amrithHN/stm32f4xx_minimal_dev/README.md

# Stm32f407 based board with barometer sensor
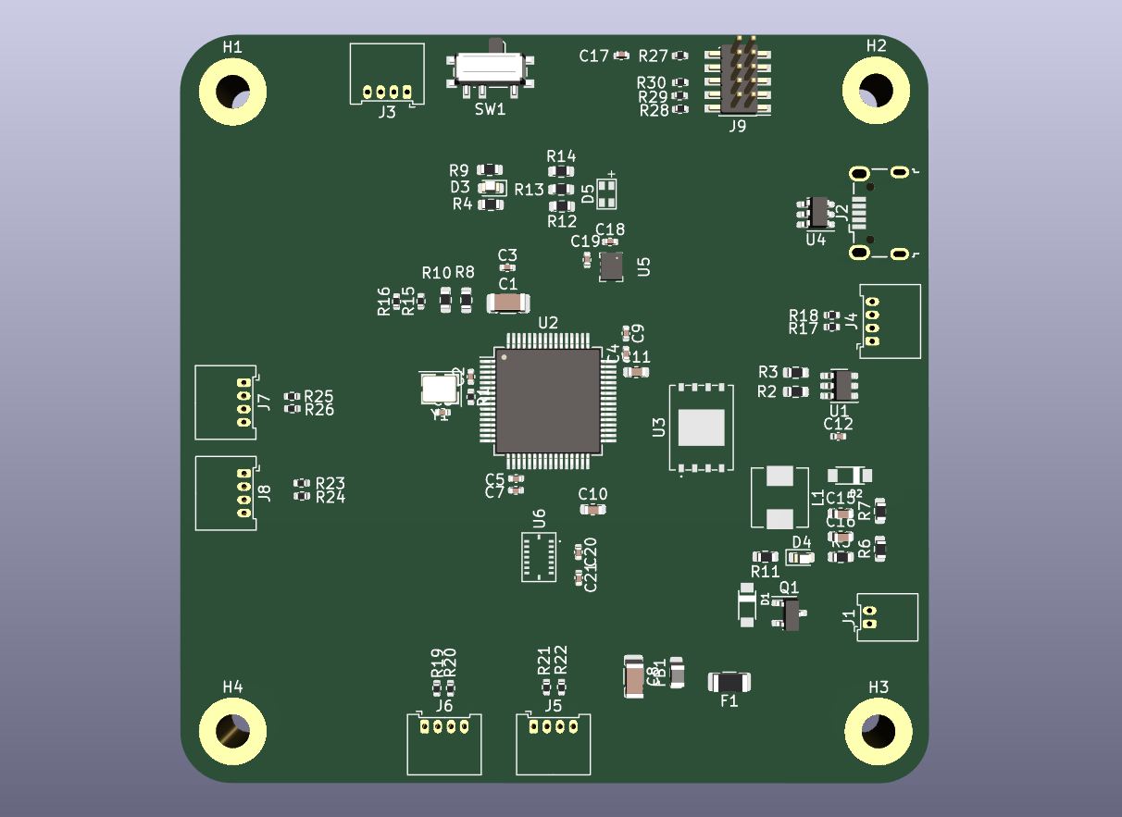
[picture p1: Screenshot 2022-11-29 144700.png]


GPL license
