amrithHN/stm32f4xx_minimal_dev/Documentation/wp5687319.webp

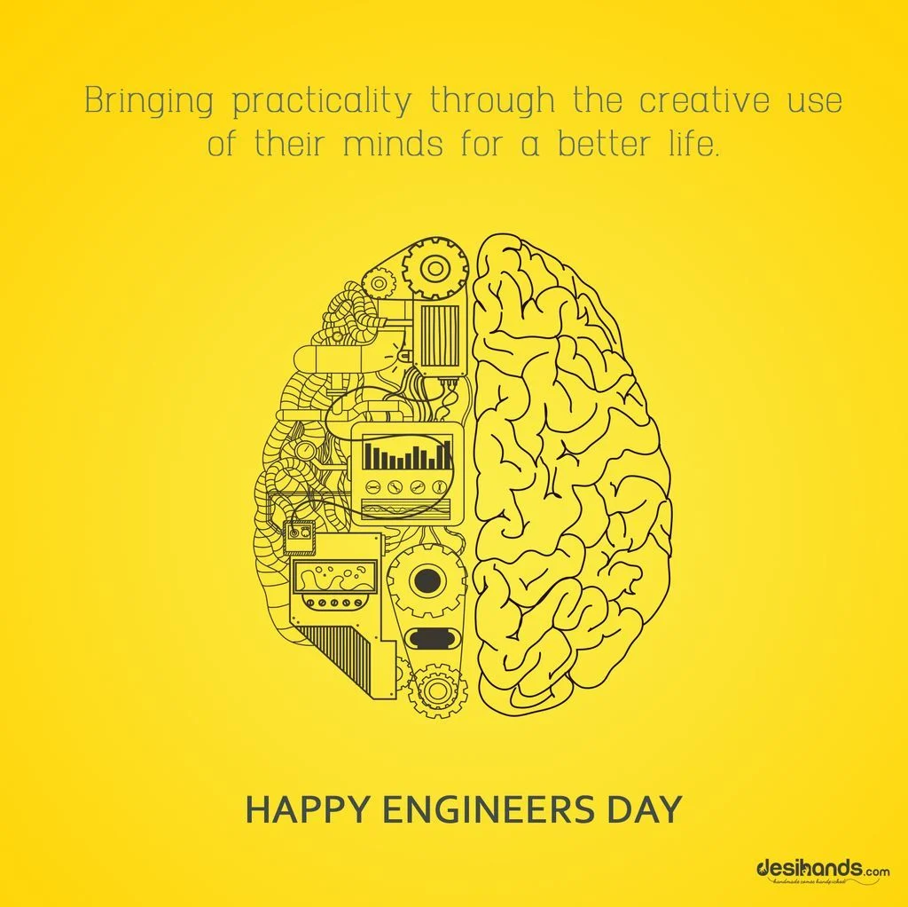
Documentation/wp5687319.webp
