amrithHN/stm32f4xx_minimal_dev/3DModels/STM32F405RGT6.STEP

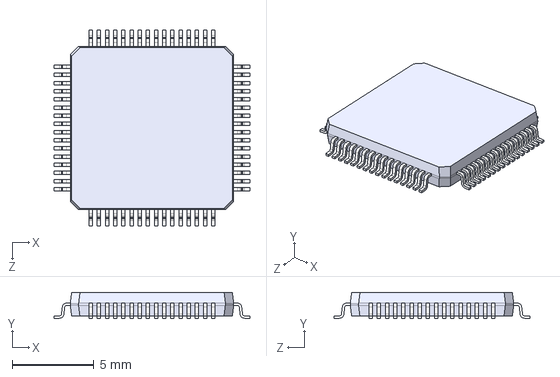
[picture p3: CAD file, 2022-11-20]
3DModels/STM32F405RGT6.STEP
12.0 x 1.60 x 12.0 mm
