amrithHN/stm32f4xx_minimal_dev/B5819W-TP/B5819W-TP.step

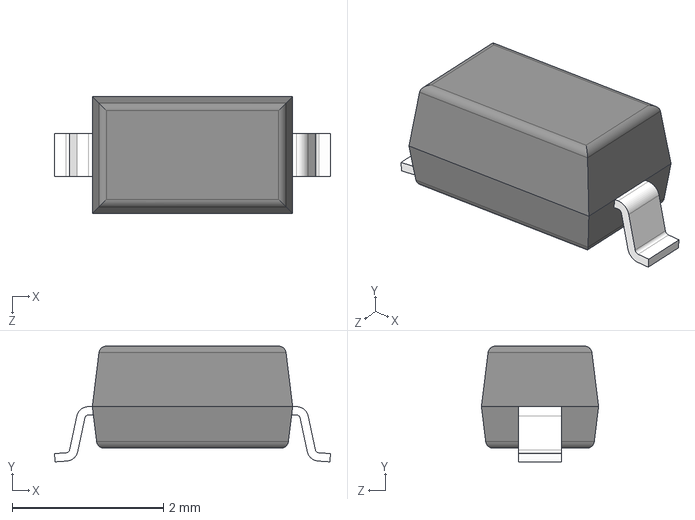
[picture p4: CAD file, 2022-11-29]
B5819W-TP/B5819W-TP.step
3.65 x 1.53 x 1.55 mm
