amrithHN/stm32f4xx_minimal_dev/BMI088/BMI088.step

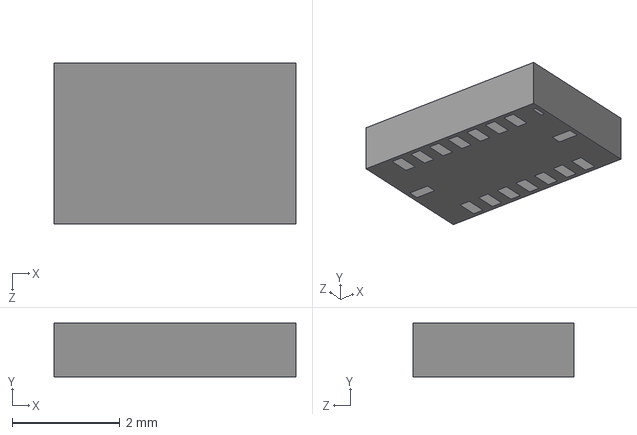
[picture p5: CAD file, 2022-11-20]
BMI088/BMI088.step
4.50 x 1.00 x 3.00 mm
