amrithHN/stm32f4xx_minimal_dev/BMP280/BMP280.step

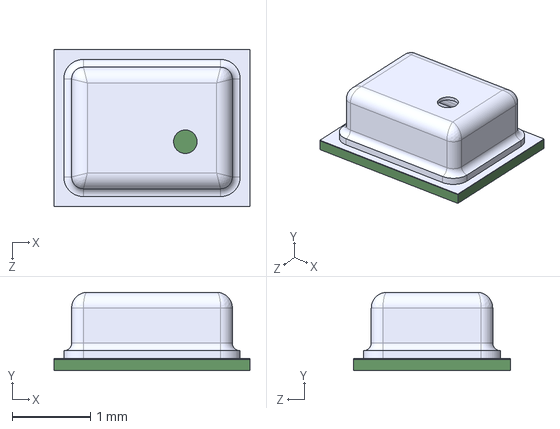
[picture p6: CAD file, 2022-11-20]
BMP280/BMP280.step
2.50 x 1.00 x 2.00 mm
