amrithHN/stm32f4xx_minimal_dev/W25N01GVZEIG_TR/W25N01GVZEIG_TR.step

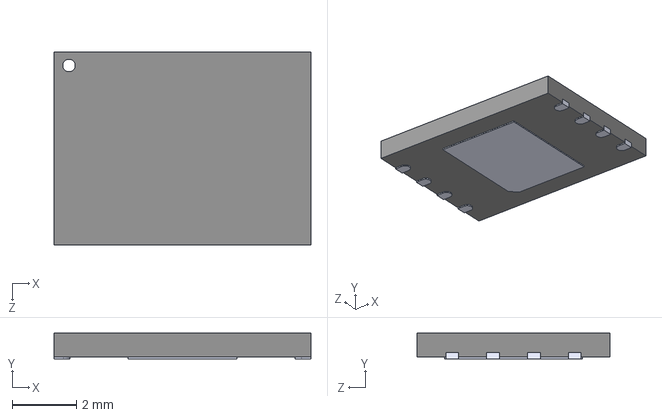
[picture p7: CAD file, 2022-11-20]
W25N01GVZEIG_TR/W25N01GVZEIG_TR.step
8.00 x 0.8 x 6.00 mm
