amrithHN/stm32f4xx_minimal_dev/stm32_f4xx_minimal.kicad_pcb

## KiCad design stm32_f4xx_minimal.kicad_pcb (2022-11-29)

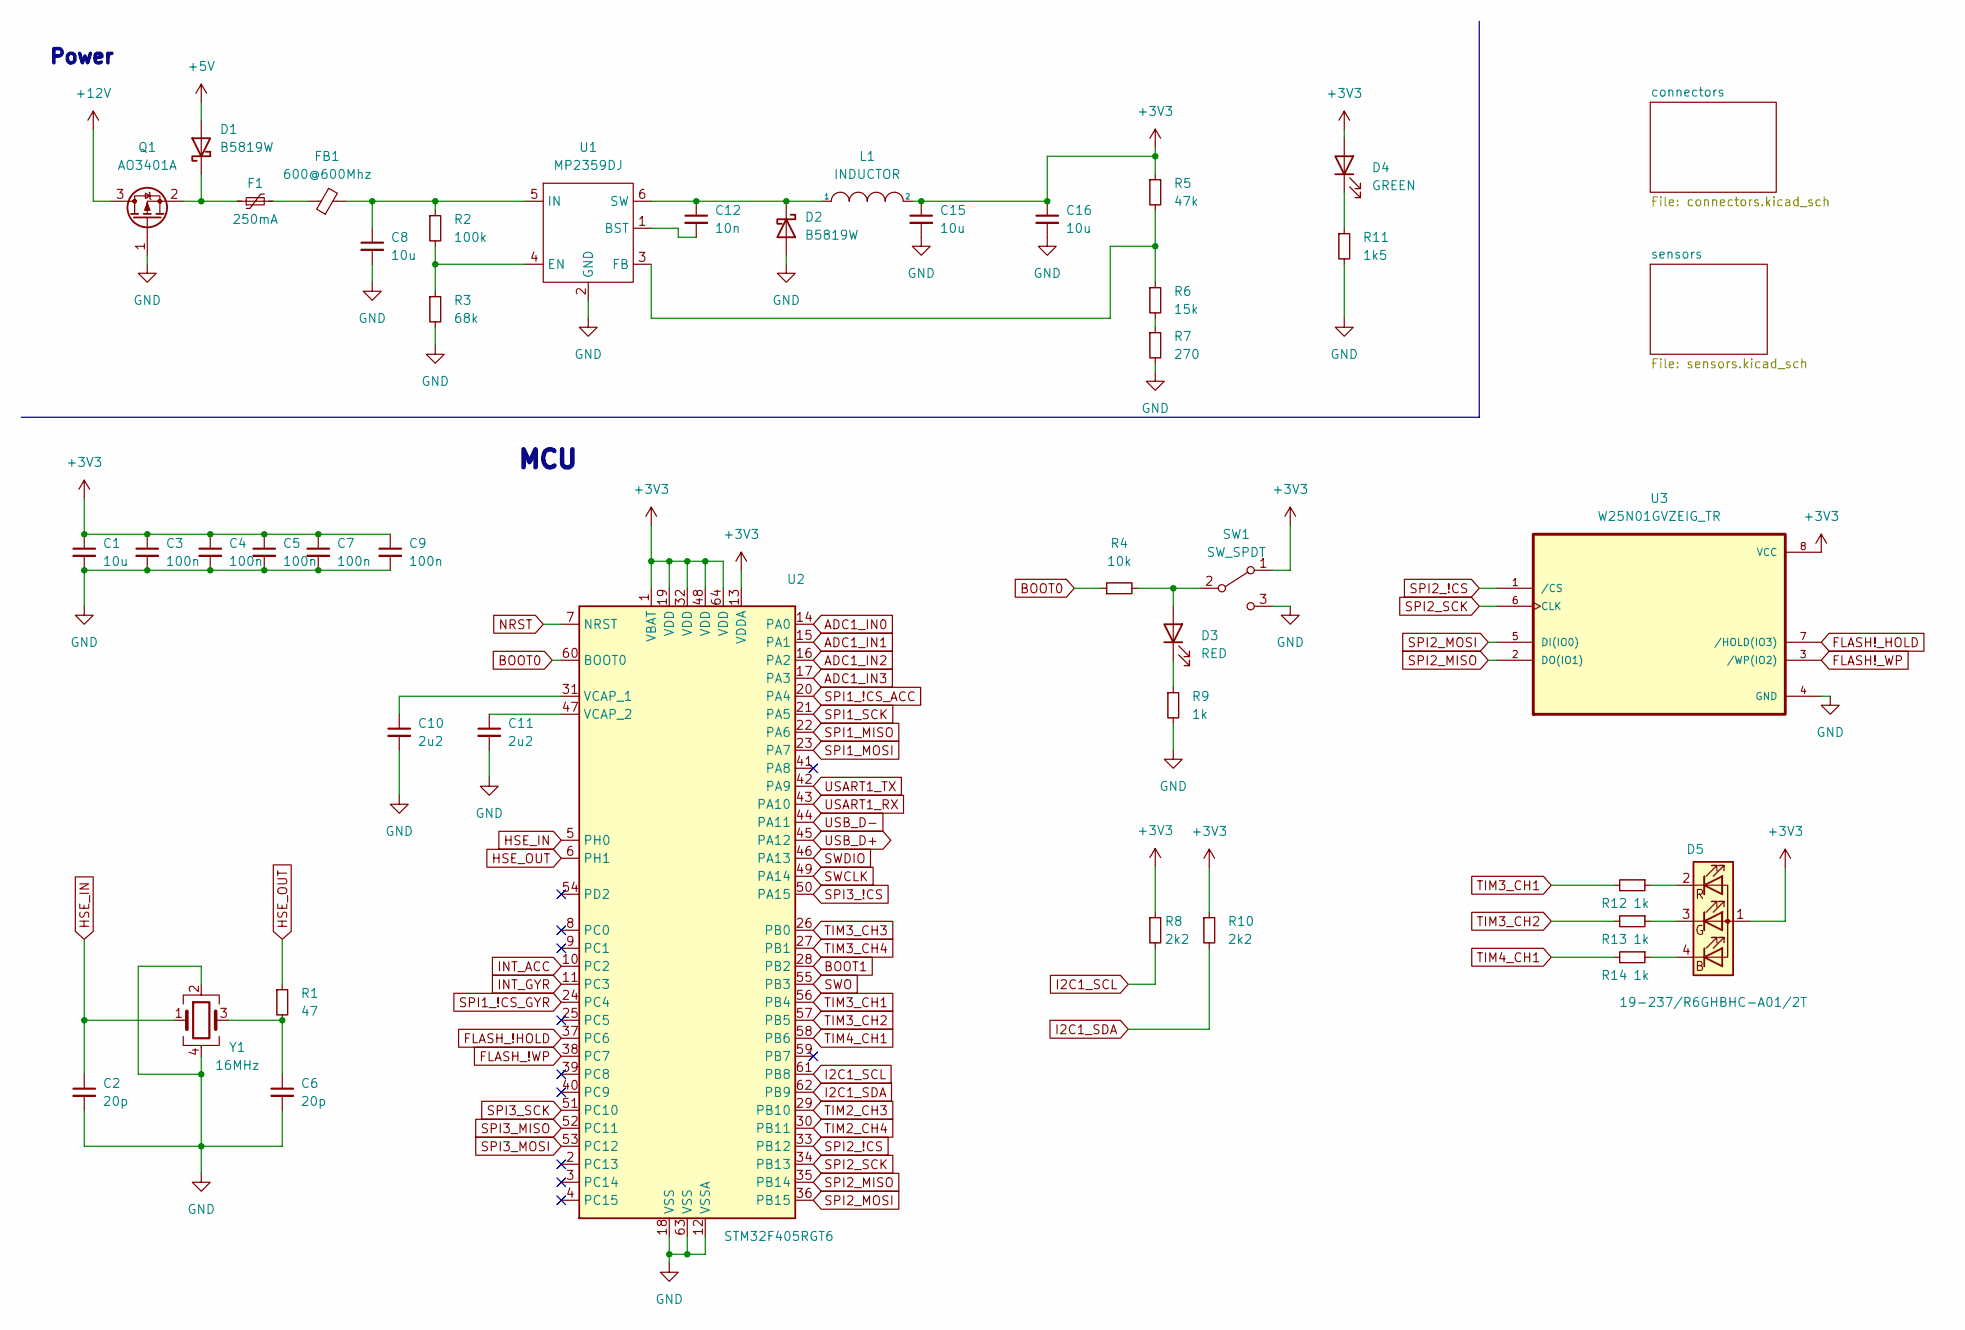
[picture p8: schematic stm32_f4xx_minimal.kicad_sch, Stm32f405RGT6]

Parts:
C1, C8: 10u; C_1206_3216Metric
C2, C6: 20p; C_0402_1005Metric
C3, C4, C5, C7, C9: 100n; C_0402_1005Metric
C10, C11: 2u2; C_0603_1608Metric
C12: 10n; C_0402_1005Metric
C15, C16: 10u; C_0603_1608Metric
D1, D2: B5819W; SOD3716X135N
D3: RED; LED_0603_1608Metric
D4: GREEN; LED_0603_1608Metric
D5: 19-237/R6GHBHC-A01/2T; 19-237-R6GHBHC-A01-2T
F1: 250mA; Fuse_1206_3216Metric
FB1: 600@600Mhz; L_0805_2012Metric
L1: INDUCTOR; L_Sunlord_MWSA0518_5.4x5.2mm
Q1: AO3401A; SOT-23
R1: 47; R_0402_1005Metric
R2: 100k; R_0603_1608Metric
R3: 68k; R_0603_1608Metric
R4: 10k; R_0603_1608Metric
R5: 47k; R_0603_1608Metric
R6: 15k; R_0603_1608Metric
R7: 270; R_0603_1608Metric
R8, R10: 2k2; R_0603_1608Metric
R9, R12, R13, R14: 1k; R_0603_1608Metric
R11: 1k5; R_0603_1608Metric
SW1: SW_SPDT; SW_SPDT_PCM12
U1: MP2359DJ; SOT-23-6
U2: STM32F405RGT6; LQFP-64_10x10mm_P0.5mm
U3: W25N01GVZEIG_TR; W25N01GVZEIG
Y1: 16MHz; Crystal_SMD_3225-4Pin_3.2x2.5mm

Connections:
+3V3: C1.1, C3.1, C4.1, C5.1, C7.1, C9.1, C15.1, C16.1, D4.2 (A), D5.1 (A), L1.2, R5.1, R8.1, R10.1, SW1.1 (A), U2.1 (VBAT), U2.13 (VDDA), U2.19 (VDD), U2.32 (VDD), U2.48 (VDD), U2.64 (VDD), U3.8 (VCC); also elsewhere on the board
+5V: D1.2 (A); also elsewhere on the board
+12V: Q1.3 (D); also elsewhere on the board
ADC1_IN0: U2.14 (PA0); also elsewhere on the board
ADC1_IN1: U2.15 (PA1); also elsewhere on the board
ADC1_IN2: U2.16 (PA2); also elsewhere on the board
ADC1_IN3: U2.17 (PA3); also elsewhere on the board
BOOT0: R4.1, U2.60 (BOOT0)
BOOT1: U2.28 (PB2)
FLASH!_HOLD: U3.7 (/HOLD(IO3))
FLASH!_WP: U3.3 (/WP(IO2))
FLASH_!HOLD: U2.37 (PC6)
FLASH_!WP: U2.38 (PC7)
GND: C1.2, C2.2, C3.2, C4.2, C5.2, C6.2, C7.2, C8.2, C9.2, C10.2, C11.2, C15.2, C16.2, D2.2 (A), Q1.1 (G), R3.2, R7.2, R9.2, R11.2, SW1.3 (C), U1.2 (GND), U2.12 (VSSA), U2.18 (VSS), U2.63 (VSS), U3.4 (GND), Y1.2, Y1.4; also elsewhere on the board
HSE_IN: C2.1, U2.5 (PH0), Y1.1
HSE_OUT: R1.1, U2.6 (PH1)
I2C1_SCL: R8.2, U2.61 (PB8); also elsewhere on the board
I2C1_SDA: R10.2, U2.62 (PB9); also elsewhere on the board
INT_ACC: U2.10 (PC2); also elsewhere on the board
INT_GYR: U2.11 (PC3); also elsewhere on the board
NRST: U2.7 (NRST); also elsewhere on the board
unnamed: C6.1, R1.2, Y1.3
unnamed: C8.1, FB1.2, R2.1, U1.5 (IN)
unnamed: C10.1, U2.31 (VCAP_1)
unnamed: C11.1, U2.47 (VCAP_2)
unnamed: C12.1, D2.1 (K), L1.1, U1.6 (SW)
unnamed: C12.2, U1.1 (BST)
unnamed: D1.1 (K), F1.1, Q1.2 (S)
unnamed: D3.1 (K), R9.1
unnamed: D3.2 (A), R4.2, SW1.2 (B)
unnamed: D4.1 (K), R11.1
unnamed: D5.2 (RK), R12.1
unnamed: D5.3 (GK), R13.1
unnamed: D5.4 (BK), R14.1
unnamed: F1.2, FB1.1
unnamed: R2.2, R3.1, U1.4 (EN)
unnamed: R5.2, R6.1, U1.3 (FB)
unnamed: R6.2, R7.1
SPI1_!CS_ACC: U2.20 (PA4); also elsewhere on the board
SPI1_!CS_GYR: U2.24 (PC4); also elsewhere on the board
SPI1_MISO: U2.22 (PA6); also elsewhere on the board
SPI1_MOSI: U2.23 (PA7); also elsewhere on the board
SPI1_SCK: U2.21 (PA5); also elsewhere on the board
SPI2_!CS: U2.33 (PB12), U3.1 (/CS)
SPI2_MISO: U2.35 (PB14), U3.2 (DO(IO1))
SPI2_MOSI: U2.36 (PB15), U3.5 (DI(IO0))
SPI2_SCK: U2.34 (PB13), U3.6 (CLK)
SPI3_!CS: U2.50 (PA15); also elsewhere on the board
SPI3_MISO: U2.52 (PC11); also elsewhere on the board
SPI3_MOSI: U2.53 (PC12); also elsewhere on the board
SPI3_SCK: U2.51 (PC10); also elsewhere on the board
SWCLK: U2.49 (PA14); also elsewhere on the board
SWDIO: U2.46 (PA13); also elsewhere on the board
SWO: U2.55 (PB3); also elsewhere on the board
TIM2_CH3: U2.29 (PB10); also elsewhere on the board
TIM2_CH4: U2.30 (PB11); also elsewhere on the board
TIM3_CH1: R12.2, U2.56 (PB4)
TIM3_CH2: R13.2, U2.57 (PB5)
TIM3_CH3: U2.26 (PB0); also elsewhere on the board
TIM3_CH4: U2.27 (PB1); also elsewhere on the board
TIM4_CH1: R14.2, U2.58 (PB6)
USART1_RX: U2.43 (PA10); also elsewhere on the board
USART1_TX: U2.42 (PA9); also elsewhere on the board
USB_D+: U2.45 (PA12); also elsewhere on the board
USB_D-: U2.44 (PA11); also elsewhere on the board

Notes on the sheet:
MCU
Power

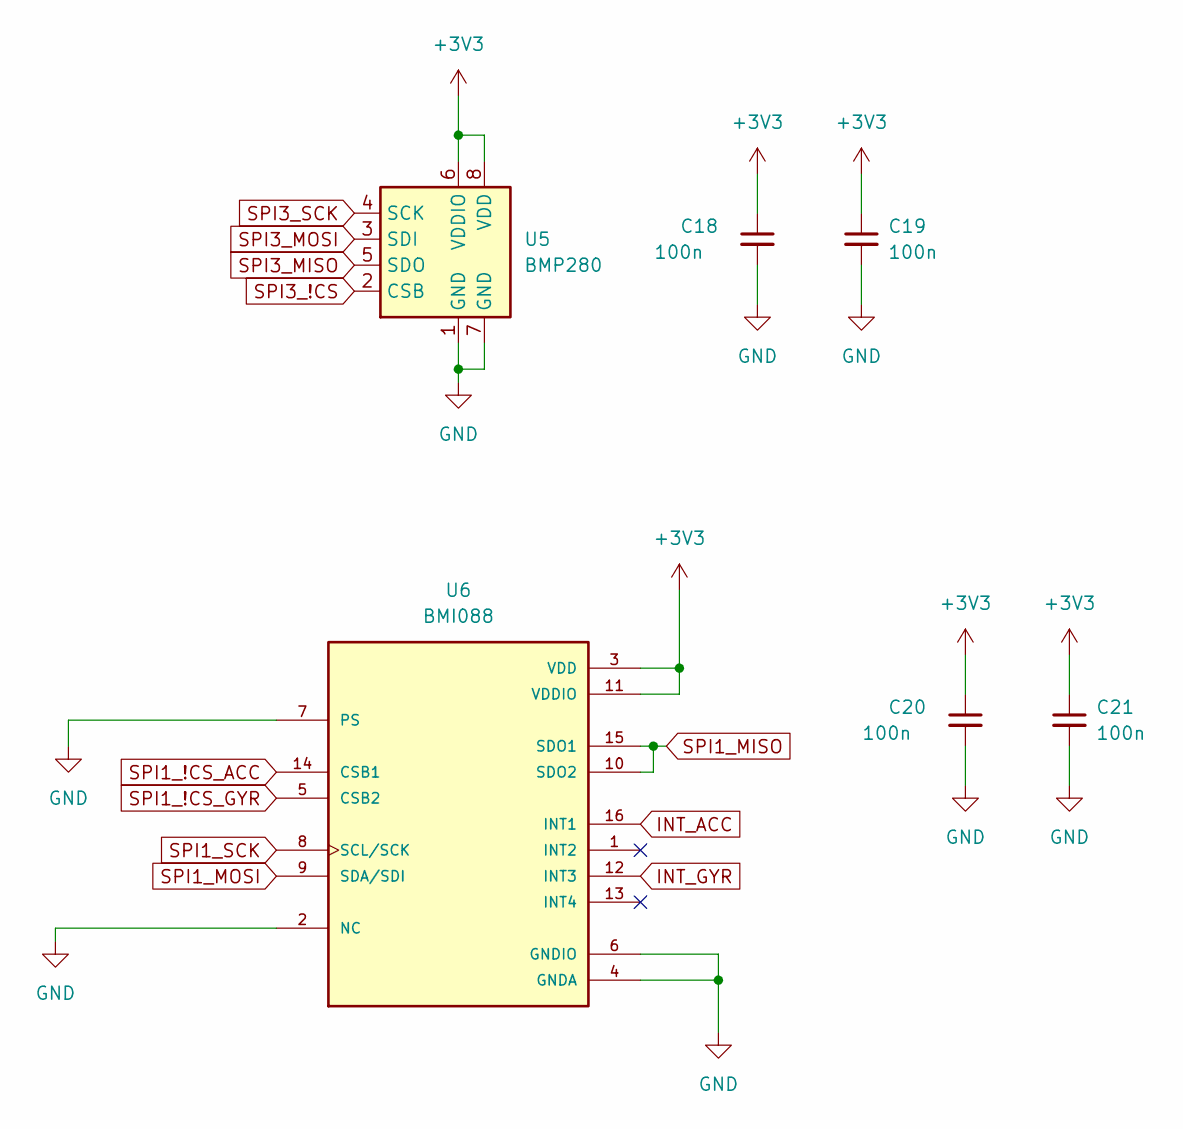
[picture p9: schematic sensors.kicad_sch]

Parts:
C18, C19, C20, C21: 100n; C_0402_1005Metric
U5: BMP280; Bosch_LGA-8_2x2.5mm_P0.65mm_ClockwisePinNumbering
U6: BMI088

Connections:
+3V3: C18.1, C19.1, C20.1, C21.1, U5.6 (VDDIO), U5.8 (VDD), U6.3 (VDD), U6.11 (VDDIO); also elsewhere on the board
GND: C18.2, C19.2, C20.2, C21.2, U5.1 (GND), U5.7 (GND), U6.2 (NC), U6.4 (GNDA), U6.6 (GNDIO), U6.7 (PS); also elsewhere on the board
INT_ACC: U6.16 (INT1); also elsewhere on the board
INT_GYR: U6.12 (INT3); also elsewhere on the board
SPI1_!CS_ACC: U6.14 (CSB1); also elsewhere on the board
SPI1_!CS_GYR: U6.5 (CSB2); also elsewhere on the board
SPI1_MISO: U6.10 (SDO2), U6.15 (SDO1); also elsewhere on the board
SPI1_MOSI: U6.9 (SDA/SDI); also elsewhere on the board
SPI1_SCK: U6.8 (SCL/SCK); also elsewhere on the board
SPI3_!CS: U5.2 (CSB); also elsewhere on the board
SPI3_MISO: U5.5 (SDO); also elsewhere on the board
SPI3_MOSI: U5.3 (SDI); also elsewhere on the board
SPI3_SCK: U5.4 (SCK); also elsewhere on the board

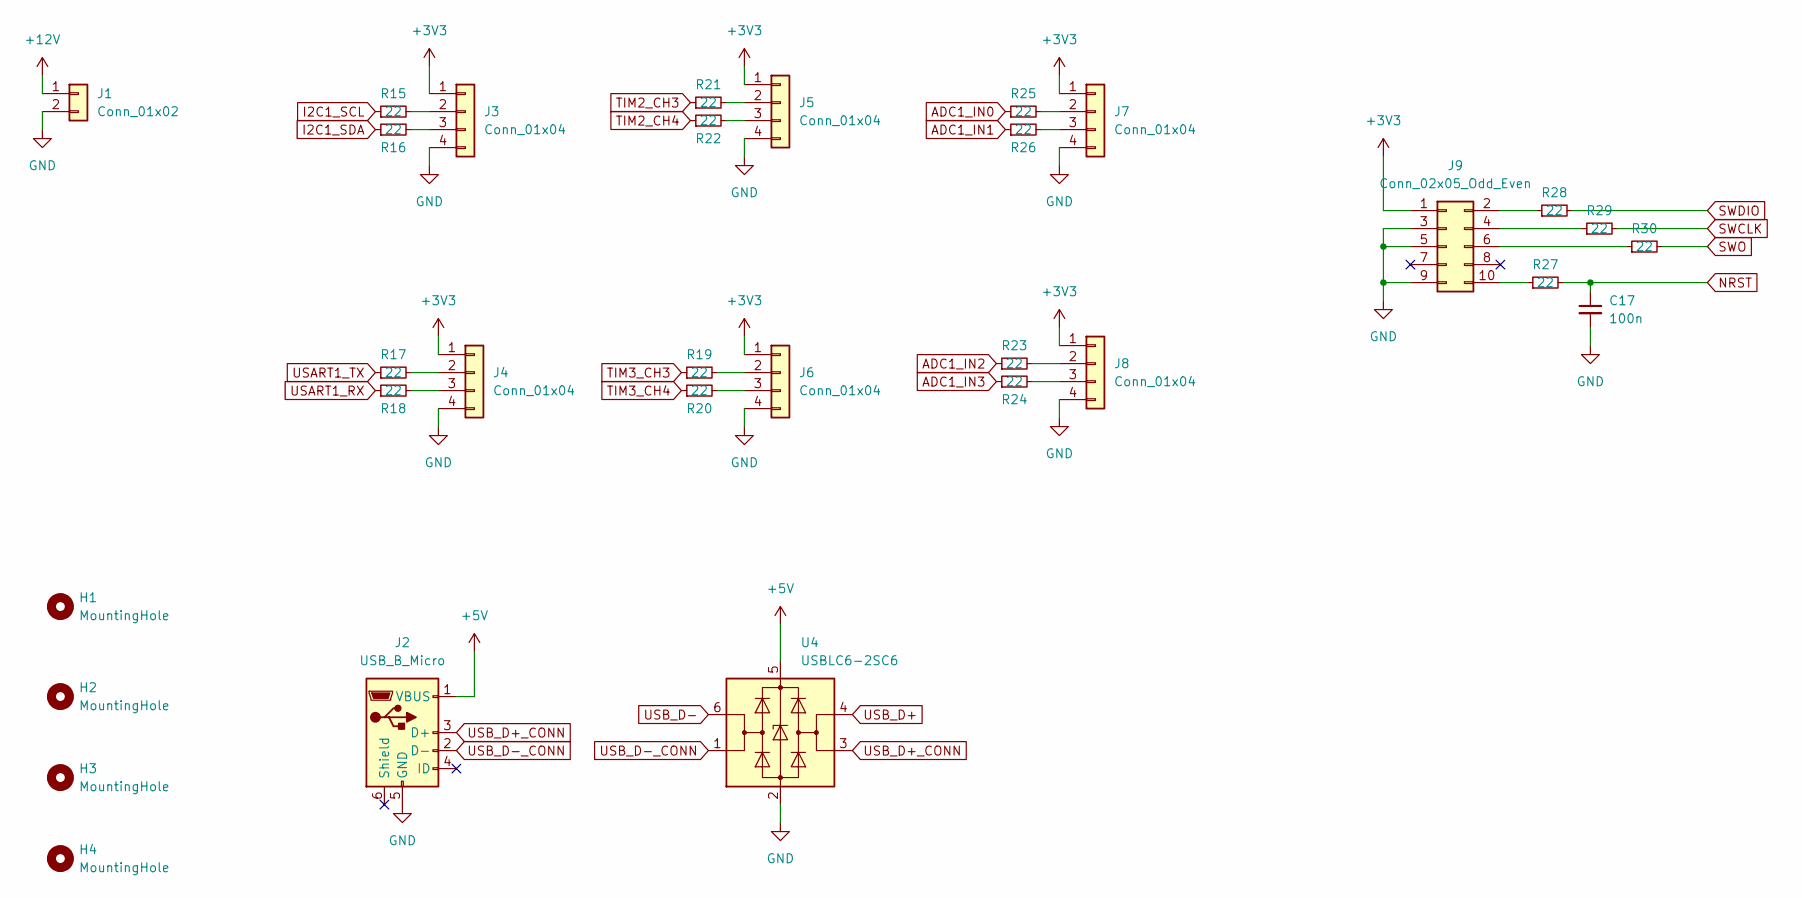
[picture p10: schematic connectors.kicad_sch]

Parts:
C17: 100n; C_0402_1005Metric
H1, H2, H3, H4: MountingHole; MountingHole_3.2mm_M3_Pad
J1: Conn_01x02; Molex_PicoBlade_53048-0210_1x02_P1.25mm_Horizontal
J2: USB_B_Micro; USB_Micro-B_Wuerth_629105150521
J3, J4, J5, J6, J7, J8: Conn_01x04; Molex_PicoBlade_53048-0410_1x04_P1.25mm_Horizontal
J9: Conn_02x05_Odd_Even; PinHeader_2x05_P1.27mm_Vertical_SMD
R15, R16, R17, R18, R19, R20, R21, R22, R23, R24, R25, R26, R27, R28, R29, R30: 22; R_0402_1005Metric
U4: USBLC6-2SC6; SOT-23-6

Connections:
+3V3: J3.1, J4.1, J5.1, J6.1, J7.1, J8.1, J9.1; also elsewhere on the board
+5V: J2.1 (VBUS), U4.5 (VBUS); also elsewhere on the board
+12V: J1.1; also elsewhere on the board
ADC1_IN0: R25.1; also elsewhere on the board
ADC1_IN1: R26.1; also elsewhere on the board
ADC1_IN2: R23.1; also elsewhere on the board
ADC1_IN3: R24.1; also elsewhere on the board
GND: C17.2, J1.2, J2.5 (GND), J3.4, J4.4, J5.4, J6.4, J7.4, J8.4, J9.3, J9.5, J9.9, U4.2 (GND); also elsewhere on the board
I2C1_SCL: R15.1; also elsewhere on the board
I2C1_SDA: R16.1; also elsewhere on the board
NRST: C17.1, R27.2; also elsewhere on the board
unnamed: J3.2, R15.2
unnamed: J3.3, R16.2
unnamed: J4.2, R17.2
unnamed: J4.3, R18.2
unnamed: J5.2, R21.2
unnamed: J5.3, R22.2
unnamed: J6.2, R19.2
unnamed: J6.3, R20.2
unnamed: J7.2, R25.2
unnamed: J7.3, R26.2
unnamed: J8.2, R23.2
unnamed: J8.3, R24.2
unnamed: J9.2, R28.1
unnamed: J9.4, R29.1
unnamed: J9.6, R30.1
unnamed: J9.10, R27.1
SWCLK: R29.2; also elsewhere on the board
SWDIO: R28.2; also elsewhere on the board
SWO: R30.2; also elsewhere on the board
TIM2_CH3: R21.1; also elsewhere on the board
TIM2_CH4: R22.1; also elsewhere on the board
TIM3_CH3: R19.1; also elsewhere on the board
TIM3_CH4: R20.1; also elsewhere on the board
USART1_RX: R18.1; also elsewhere on the board
USART1_TX: R17.1; also elsewhere on the board
USB_D+: U4.4 (I/O2); also elsewhere on the board
USB_D+_CONN: J2.3 (D+), U4.3 (I/O2)
USB_D-: U4.6 (I/O1); also elsewhere on the board
USB_D-_CONN: J2.2 (D-), U4.1 (I/O1)

Board: 4 copper layers, 79 parts (0 on the bottom side), 78 nets, no tracks yet.
