amrithHN/stm32f4xx_minimal_dev/(commit log)

2022-11-20 initial commit
    basic schematic done
    [BMI088.step, BMP280.step, STM32F405RGT6.STEP, W25N01GVZEIG_TR.step, connectors.kicad_sch, sensors.kicad_sch, stm32_f4xx_minimal.kicad_pcb, stm32_f4xx_minimal.kicad_sch]
2022-11-21 updated schematic
    [connectors.kicad_sch, sensors.kicad_sch, stm32_f4xx_minimal.kicad_sch]
2022-11-29 updated and parts placement
    basic parts placement
    [B5819W-TP.step, connectors.kicad_sch, sensors.kicad_sch, stm32_f4xx_minimal.kicad_pcb, stm32_f4xx_minimal.kicad_sch]
